Phedro-Shousa/STM32---Control-of-a-Submergible/code/Src/main.c

/**
  ******************************************************************************
  * @file           : main.c
  * @brief          : Main program body
  ******************************************************************************
  ** This notice applies to any and all portions of this file
  * that are not between comment pairs USER CODE BEGIN and
  * USER CODE END. Other portions of this file, whether 
  * inserted by the user or by software development tools
  * are owned by their respective copyright owners.
  *
  * COPYRIGHT(c) 2019 STMicroelectronics
  *
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
  ******************************************************************************
  */
/* Includes ------------------------------------------------------------------*/
#include "main.h"
#include "stm32f7xx_hal.h"
#include "adc.h"
#include "tim.h"
#include "usart.h"
#include "gpio.h"

/* USER CODE BEGIN Includes */
#include "interface.h"
#include "limitacao.h"
#include "controlo.h"
#include "string.h"
/*
#include "main.h"
#include "stm32f7xx_hal.h"
#include "adc.h"
#include "tim.h"
#include "usart.h"
#include "gpio.h"
#include "interface.h"

*/
/* USER CODE END Includes */


/* USER CODE BEGIN PV */

/* USER CODE END PV */

void SystemClock_Config(void);

/* USER CODE BEGIN PFP */

/* USER CODE END PFP */

/* USER CODE BEGIN 0 */
void interface(void);
int exec_getValue(float *valor);
int test_graf;
int valor_referencia;
/* USER CODE END 0 */

/**
  * @brief  The application entry point.
  *
  * @retval None
  */
int main(void)
{
  /* MCU Configuration----------------------------------------------------------*/

  /* Reset of all peripherals, Initializes the Flash interface and the Systick. */
  HAL_Init();

  /* Configure the system clock */
  SystemClock_Config();

  /* Initialize all configured peripherals */
  MX_GPIO_Init();
  MX_ADC1_Init();
  MX_TIM2_Init();
  MX_USART3_UART_Init();
  MX_TIM4_Init();
  MX_TIM6_Init();
  /* USER CODE BEGIN 2 */
	init_UART3();
  HAL_TIM_Base_Start_IT(&htim4); //verifica��o de limita��o
  /* USER CODE END 2 */

  /* Infinite loop */
  /* USER CODE BEGIN WHILE */
  while (1)
  {
  //output_t(aux_pwm);
		
	
		
	if(test_graf){
  //printf("CG %d i \r\n", get_error());
	printf("CG %d i \r\n",10 );	
	HAL_Delay(2);
	//printf("CP %d j \r\n",20);	//envia profundidade atual //////////////////////////////////////////////////////////////////////////////trocar 20 por valor de resis e samuel	
	HAL_GPIO_TogglePin(GPIOB, GPIO_PIN_14);
	}	
	
	if(messageReceived()){
			interface();
	}
		
	HAL_Delay(100);
  /* USER CODE END WHILE */

  /* USER CODE BEGIN 3 */

  }
  /* USER CODE END 3 */

}

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
/* USER CODE BEGIN 4 */
void interface(void)
{
		if(COMMAND[0] == 'C' && COMMAND[1] == 'Y')
	{
		test_graf=1;
	}
	
		if(COMMAND[0] == 'C' && COMMAND[1] == 'S')
	{
		test_graf=0;
	}
	
			if(COMMAND[0] == 'S' && COMMAND[1] == 'E')
	{
		float aux3;
		
		if(exec_getValue(&aux3)){
		valor_referencia = (int)aux3;
		printf("CP %d j \r\n", valor_referencia );
		}
	}
	
}

int exec_getValue(float *valor)
{
	int x=0;
	int para=0;
		int partdec=0;
		int posPoint=0;
		float value=0;
	//&value = valor;
		
		for(int i=5;i<strlen((const char*)COMMAND);i++)
		{
			if(COMMAND[i]=='.')posPoint=i;
		}
		if(posPoint!=0)
		{
		for(int i=4;i<posPoint;i++)
						{
							
							if(COMMAND[i]>='0' && COMMAND[i] <='9')
							{	
								para*=10;
								para += (COMMAND[i]-'0');
							}else para=123456;
							
						}
		for(int i=posPoint+1;i<strlen((const char*)COMMAND);i++)
						{
							
							if(COMMAND[i]>='0' && COMMAND[i] <='9')
							{	
								x++;
								partdec*=10;
								partdec += (COMMAND[i]-'0');
							}else para=123456;
							
						}
		}
		else
		{
			for(int i=3;i<strlen((const char*)COMMAND);i++)
						{
							
							if(COMMAND[i]>='0' && COMMAND[i] <='9')
							{	
								para*=10;
								para += (COMMAND[i]-'0');
							}else para=123456;
							
						}
		}
		if(para <123456)
		{
			float aux=partdec;
			int i;
			for(i=0;x>i;i++)
			{
				aux=aux/10;
				//printf("aux %f",aux);
			}
			*valor=aux+(float)para;
			//printf("Valor = %f e partdec %d e para %d",value,partdec,para);
			//Yr_ChangeValue ( value );
			return 1;
		}else			
		//printf("CYR ok\r\n");
		return 0;
		
	
	
}

/* USER CODE END 4 */
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
