Phedro-Shousa/STM32---Control-of-a-Submergible/code/Submarino.ioc

Mcu.UserName=STM32F767ZITx
PA0/WKUP.Signal=ADCx_IN0
PA13.Signal=SYS_JTMS-SWDIO
PA14.Signal=SYS_JTCK-SWCLK
PA3.Signal=GPIO_Output
PA5.Signal=S_TIM2_CH1_ETR
PB0.GPIO_Label=LED_GREEN
PB0.Signal=GPIO_Output
PB14.GPIO_Label=LED_RED
PB14.Signal=GPIO_Output
PB7.GPIO_Label=LED_BLUE
PB7.Signal=GPIO_Output
PC0.Signal=GPIO_Output
PD12.Signal=S_TIM4_CH1
PD8.Signal=USART3_TX
PD9.Signal=USART3_RX
PH0/OSC_IN.Signal=RCC_OSC_IN
PH1/OSC_OUT.Signal=RCC_OSC_OUT
